GoInK13/LaserGame/Kicad/Laser-50503D.jpg

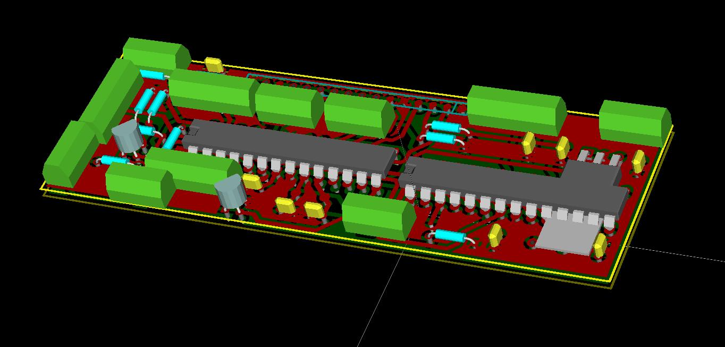
Kicad/Laser-50503D.jpg
