GoInK13/LaserGame/Programmes/SoftPCOK.png

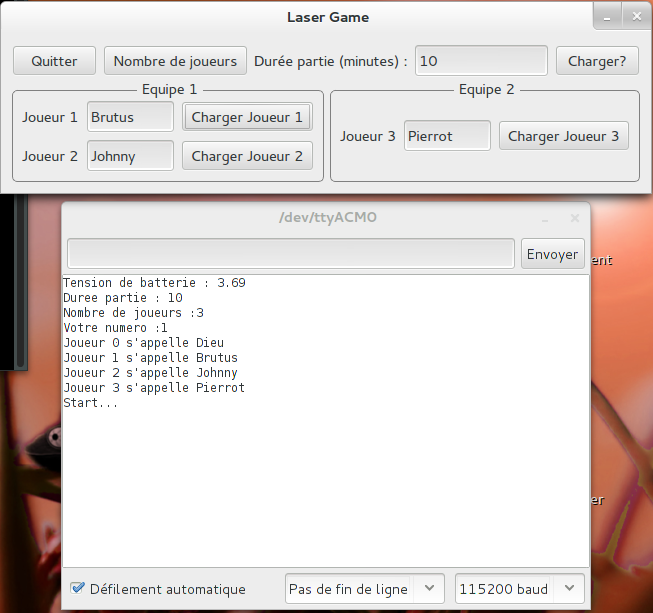
Programmes/SoftPCOK.png
