GoInK13/LaserGame/README.md

# LaserGame

The KiCAD folder contains the PCB files.
The programm folder contains the 2 programs for Arduino and the software to export names on the gun.

If you wanna see a video about it :  
https://www.youtube.com/watch?v=VjxKDo3n8c4
