GoInK13/LaserGame/Documentations/PosterProjetLaserGame_V2015_SD.pdf

# Principe du projet long

## Décomposé en 4 séquences :

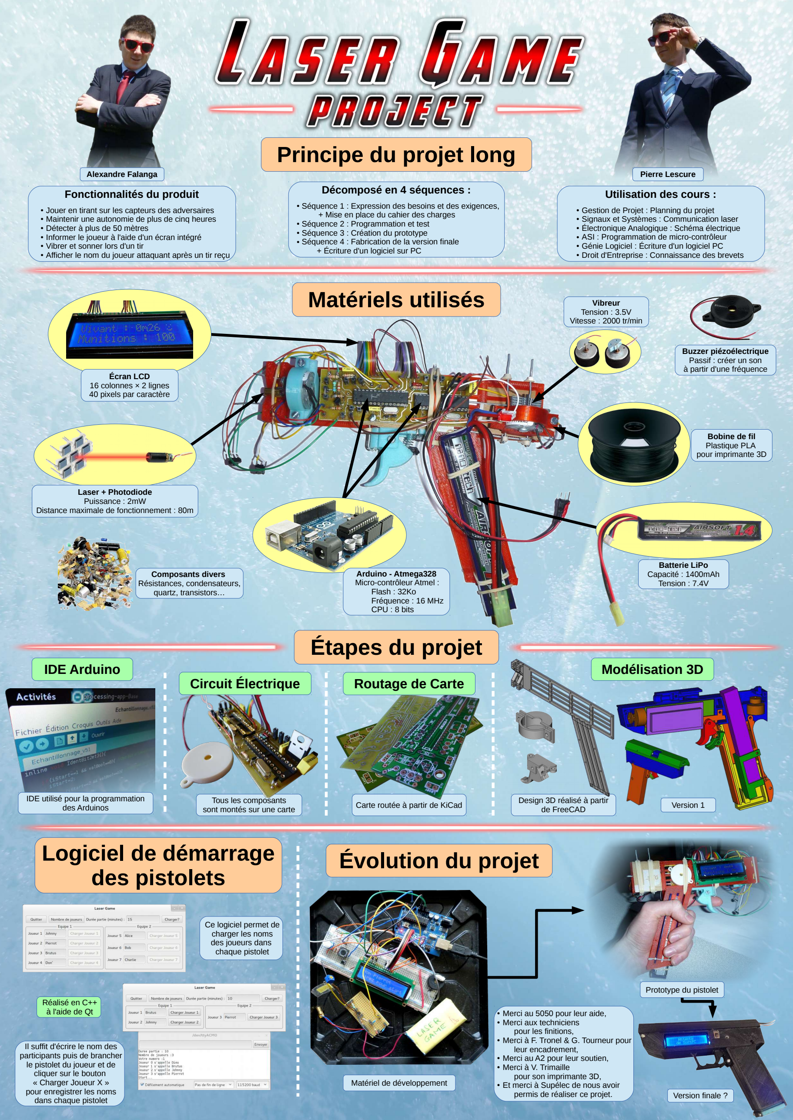
[picture p3: page 1]

# Matériels utilisés

- Séquence 1 : Expression des besoins et des exigences, + Mise en place du cahier des charges
- Séquence 2 : Programmation et test
- Séquence 3 : Création du prototype
- Séquence 4 : Fabrication de la version finale + Écriture d'un logiciel sur PC

Alexandre Falanga

## Fonctionnalités du produit

- Jouer en tirant sur les capteurs des adversaires
- Maintenir une autonomie de plus de cinq heures
- Détecter à plus de 50 mètres
- Informer le joueur à l'aide d'un écran intégré
- Vibrer et sonner lors d'un tir
- Afficher le nom du joueur attaquant après un tir reçu

Pierre Lescure

## Utilisation des cours :

- Gestion de Projet : Planning du projet
- Signaux et Systèmes : Communication laser
- Électronique Analogique : Schéma électrique
- ASI : Programmation de micro-contrôleur
- Génie Logiciel : Écriture d'un logiciel PC
- Droit d'Entreprise : Connaissance des brevets

Vibreur
Tension : 3.5V
Vitesse : 2000 tr/min

Buzzer piézoélectrique
Passif : créer un son
à partir d'une fréquence

Bobine de fil
Plastique PLA
pour imprimante 3D

Batterie LiPo
Capacité : 1400mAh
Tension : 7.4V

Arduino - Atmega328
Micro-contrôleur Atmel :
Flash : 32Ko
Fréquence : 16 MHz
CPU : 8 bits

Composants divers
Résistances, condensateurs, quartz, transistors…

Laser + Photodiode
Puissance : 2mW
Distance maximale de fonctionnement : 80m

Écran LCD
16 colonnes × 2 lignes
40 pixels par caractère

## IDE Arduino Circuit Électrique

## Modélisation 3D

# Étapes du projet

# Évolution du projet Logiciel de démarrage des pistolets

Ce logiciel permet de
charger les noms
des joueurs dans
chaque pistolet

Réalisé en C++
à l'aide de Qt

Il suffit d'écrire le nom des participants puis de brancher le pistolet du joueur et de cliquer sur le bouton
« Charger Joueur X »
pour enregistrer les noms
dans chaque pistolet

Matériel de développement

- Merci au 5050 pour leur aide,
- Merci aux techniciens
pour les finitions,
- Merci à F. Tronel & G. Tourneur pour leur encadrement,
- Merci au A2 pour leur soutien,
- Merci à V. Trimaille
pour son imprimante 3D,
- Et merci à Supélec de nous avoir permis de réaliser ce projet.

Prototype du pistolet

Version finale ?

IDE utilisé pour la programmation des Arduinos

Tous les composants
sont montés sur une carte

Carte routée à partir de KiCad

## Routage de Carte

Design 3D réalisé à partir de FreeCAD

Version 1
