GoInK13/LaserGame/Kicad/Laser01-5050-PlanDeMasse.pdf

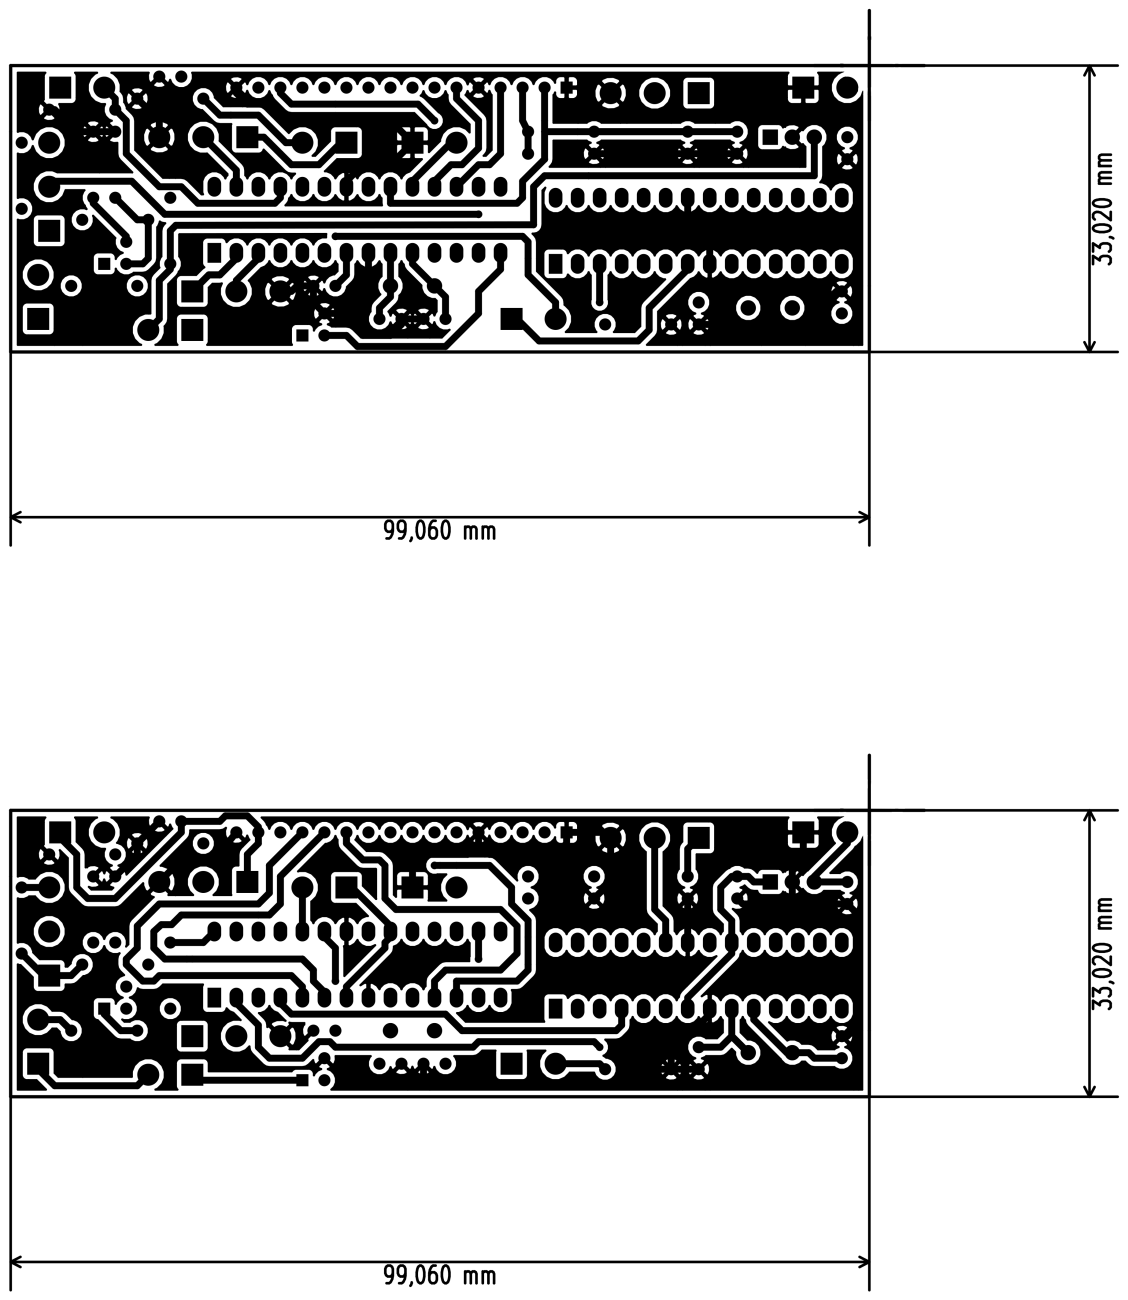
[picture p5: page 1]
