GoInK13/LaserGame/Kicad/Laser01-5050-V2SSMasse.pdf

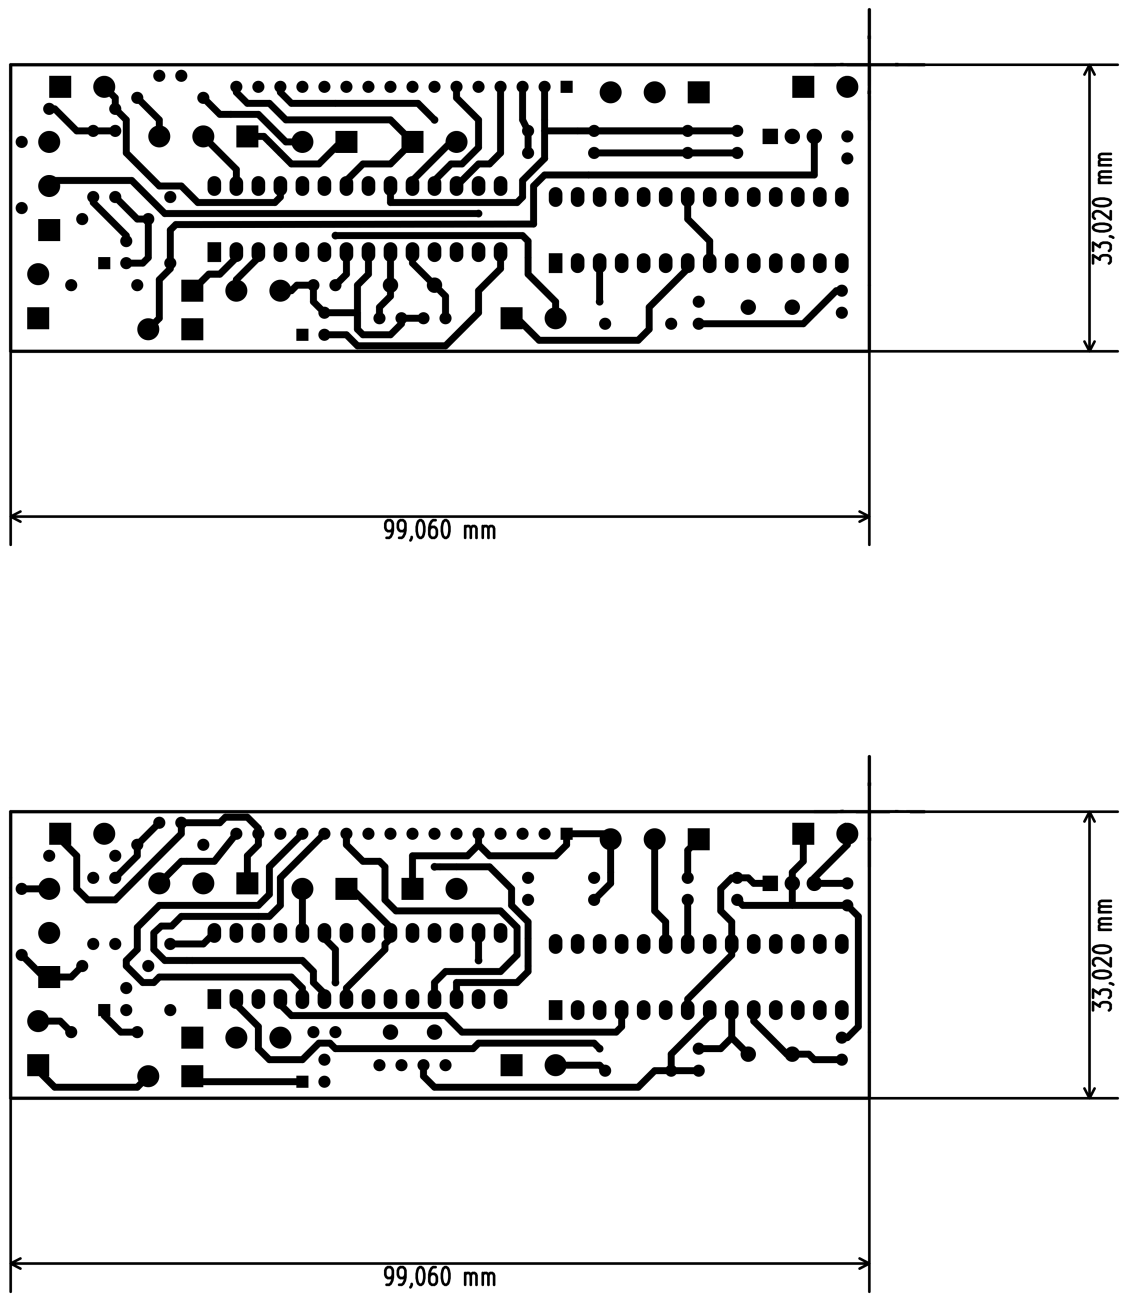
[picture p6: page 1]
