GoInK13/LaserGame/Kicad/Laser01-5050-V3-PDM.pdf

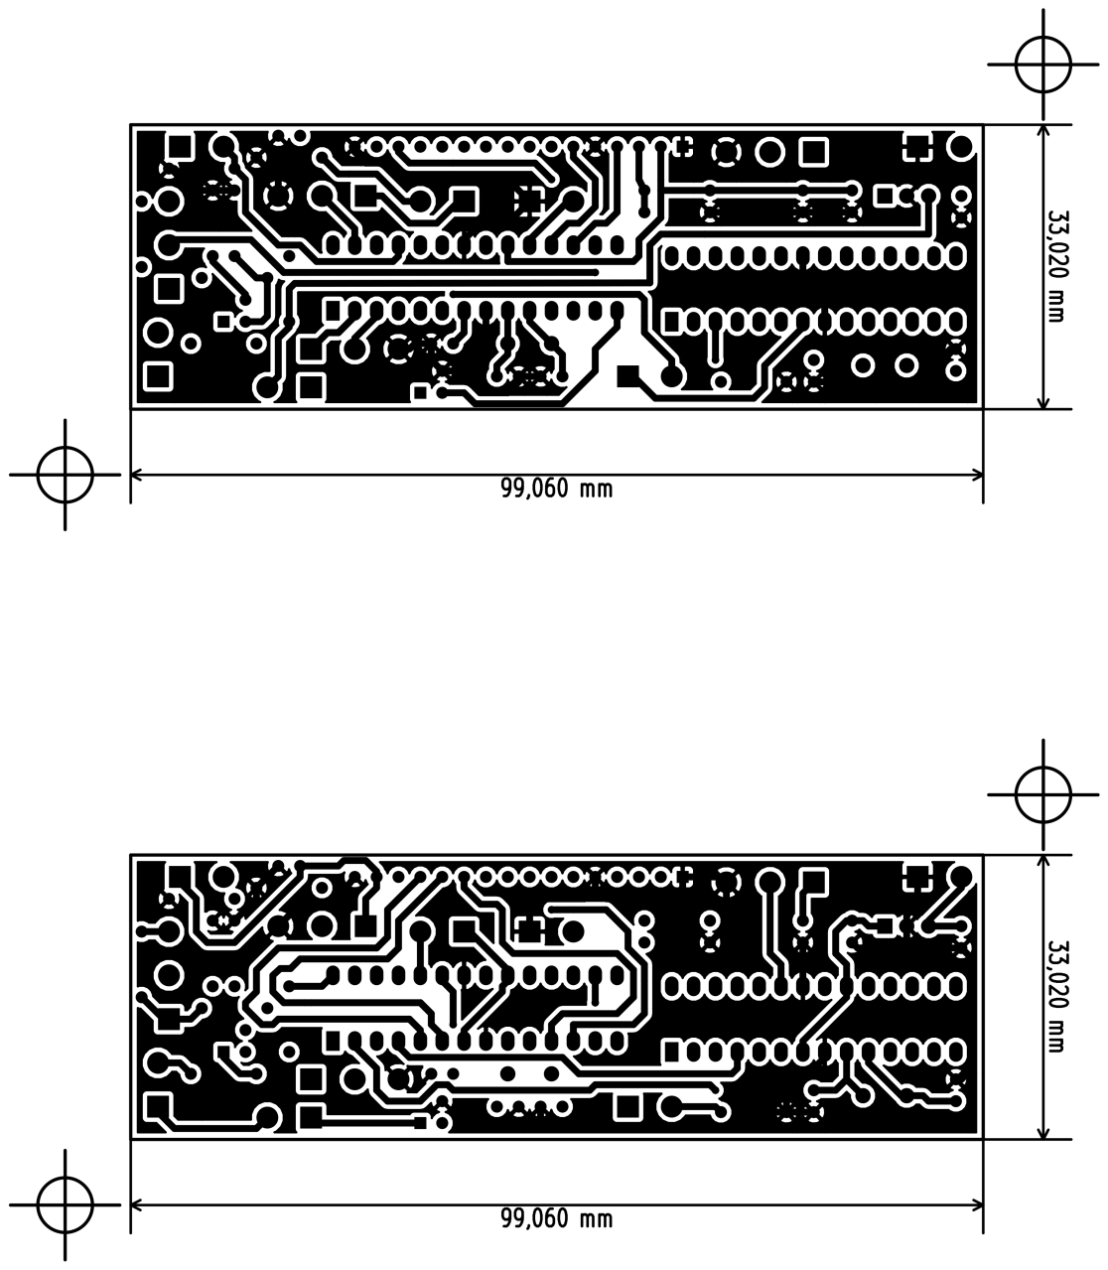
[picture p7: page 1]
