GoInK13/LaserGame/Kicad/Laser01-5050.pdf

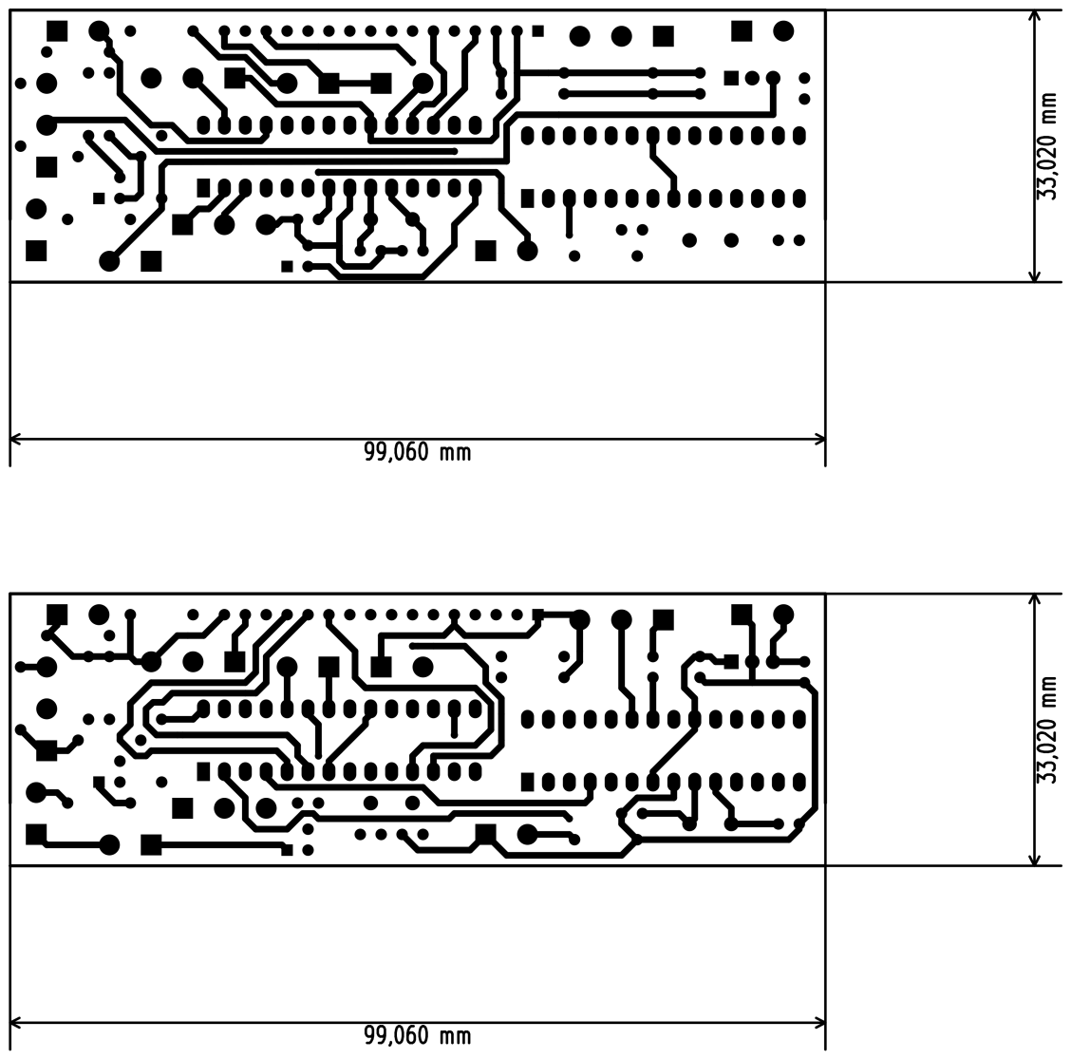
[picture p8: page 1]
