GoInK13/LaserGame/Kicad/Laser01-Routage.pdf

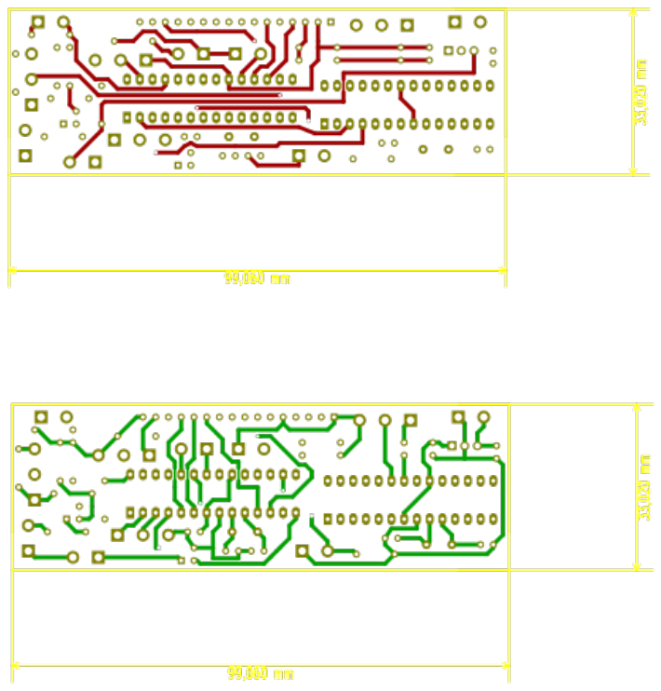
[picture p9: page 1]
