GoInK13/LaserGame/Kicad/Laser01-Routage2.pdf

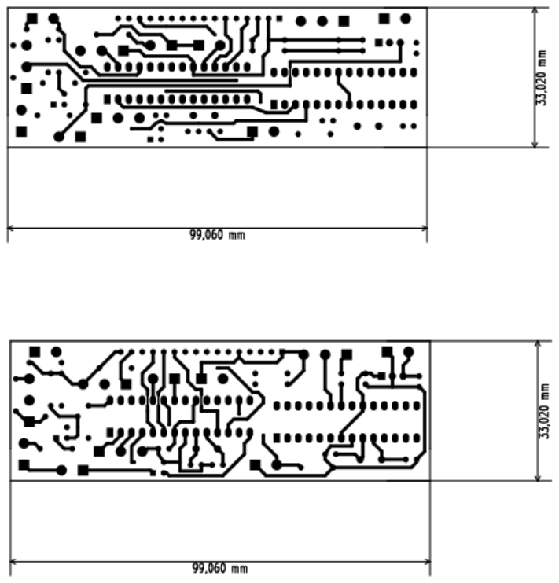
[picture p10: page 1]
