GoInK13/LaserGame/Kicad/Routage5050-0418.pdf

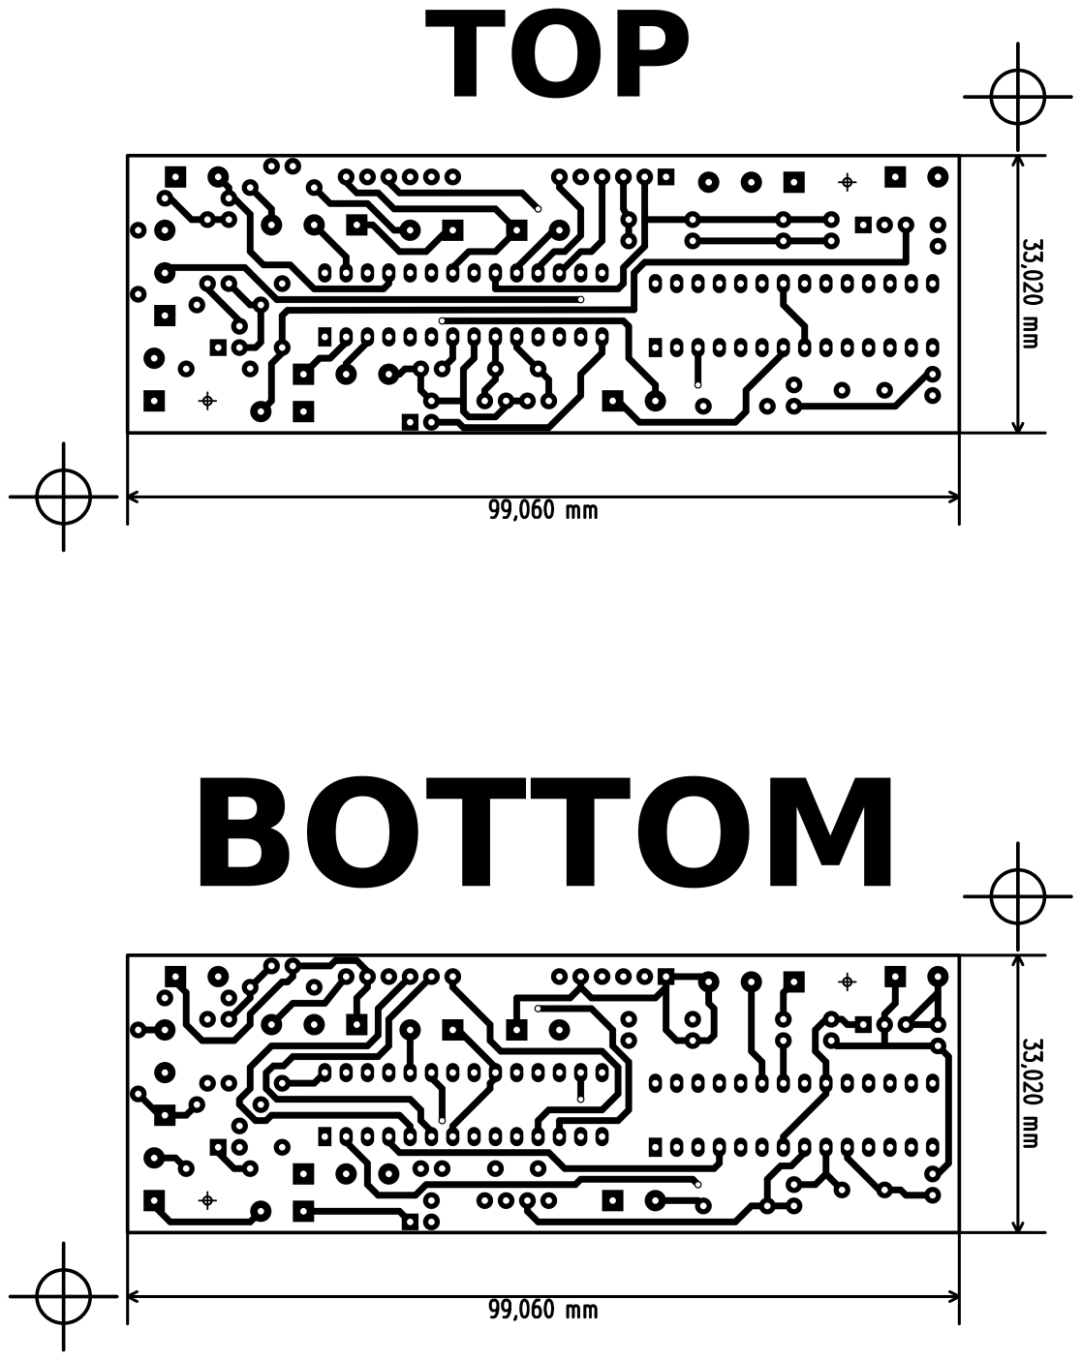
[picture p11: page 1]
