GoInK13/LaserGame/Kicad/Laser01-5050.jpg

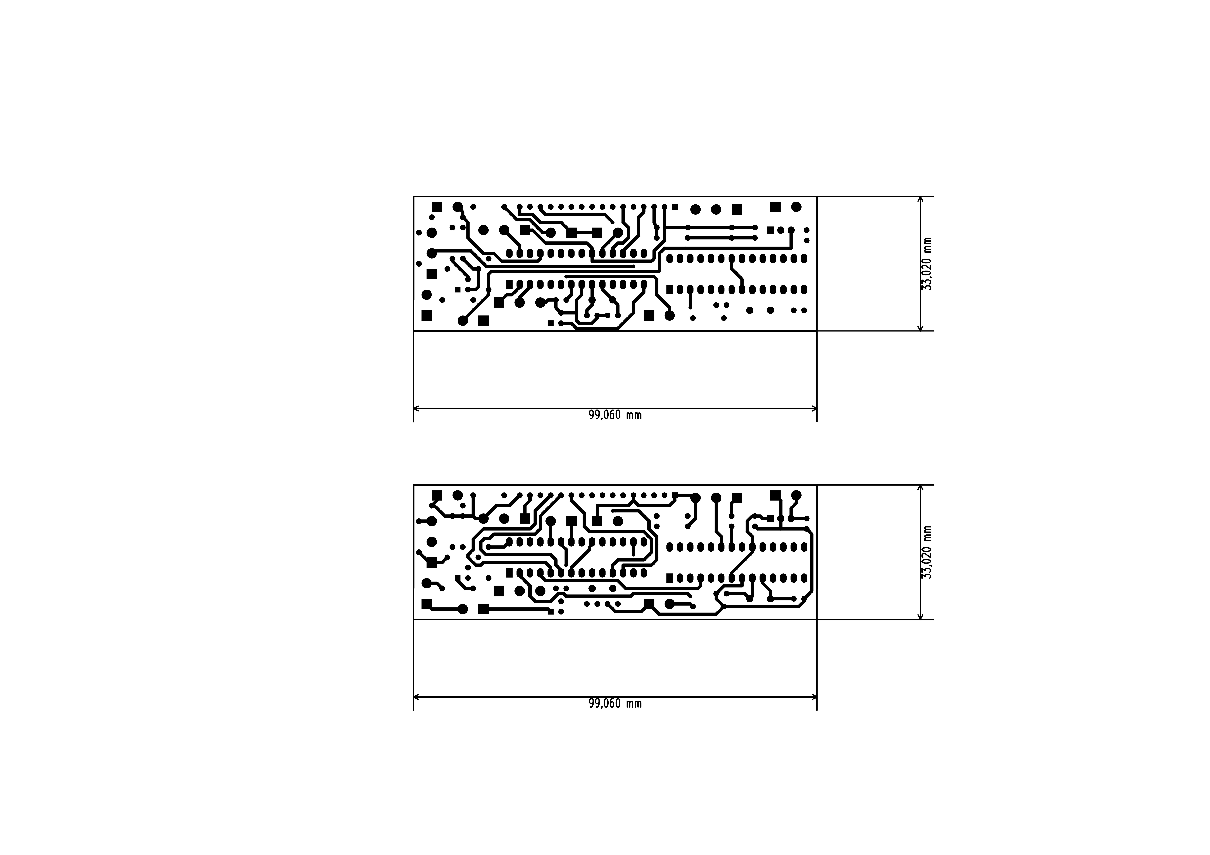
Kicad/Laser01-5050.jpg
