GoInK13/LaserGame/FreeCAD/crosseDroite.fcstd

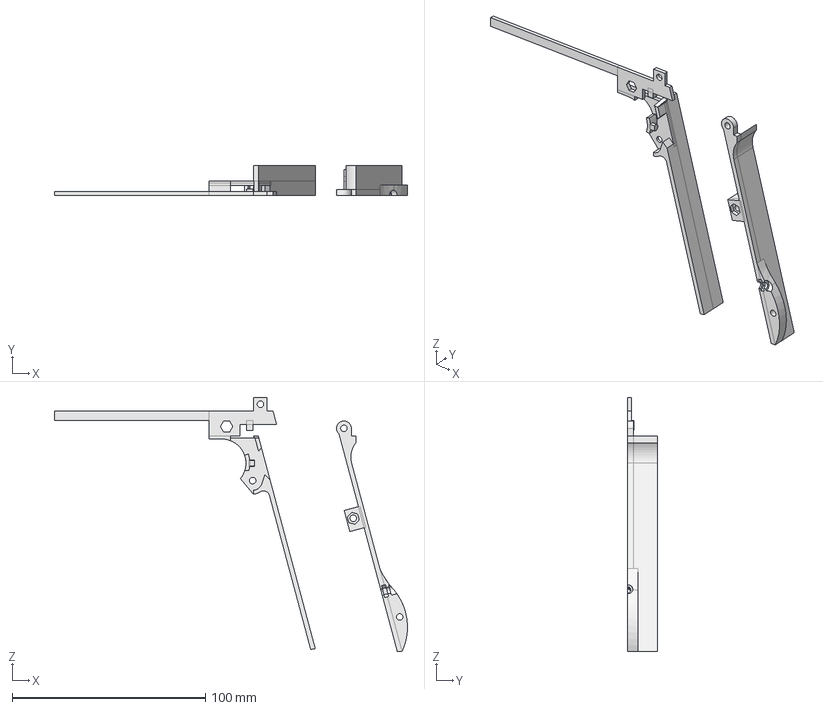
[picture p13: CAD file, 2017-12-06]
FreeCAD/crosseDroite.fcstd
182.5 x 15.5 x 131.4 mm
