GoInK13/LaserGame/FreeCAD/NgachetteTir.fcstd

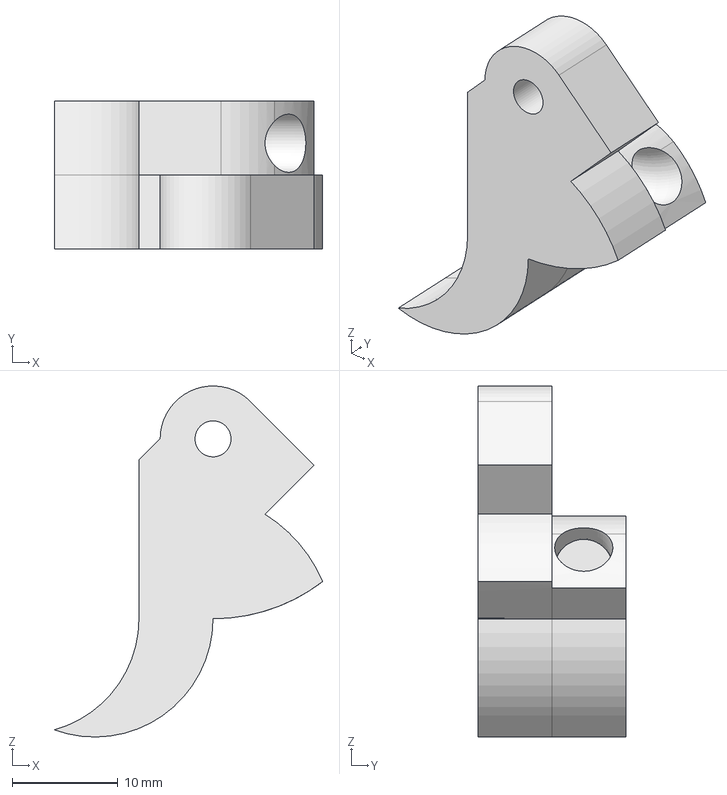
[picture p14: CAD file, 2017-12-06]
FreeCAD/NgachetteTir.fcstd
25.4 x 14.0 x 33.2 mm
