GoInK13/LaserGame/FreeCAD/HautGaucheEscroquerie.fcstd

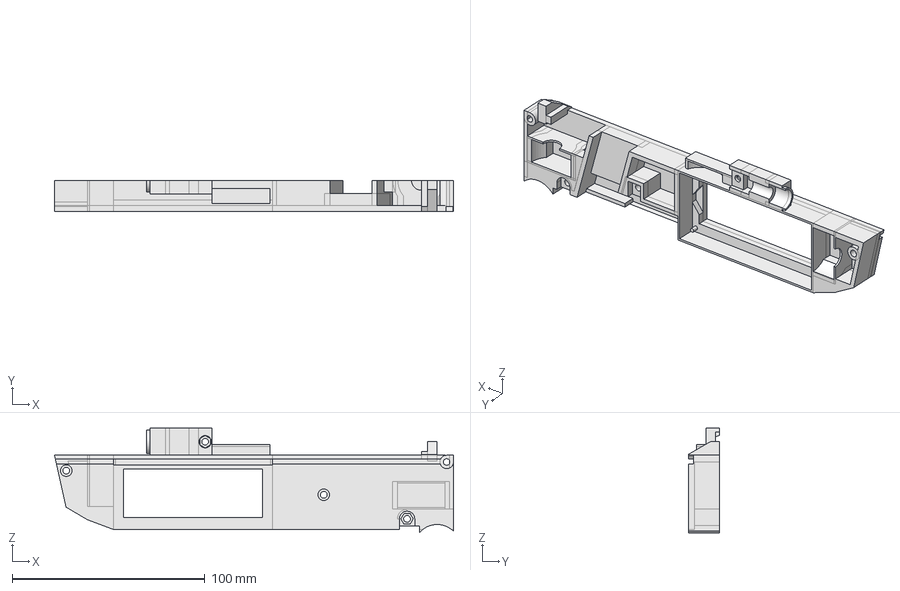
[picture p15: CAD file, 2017-12-06]
FreeCAD/HautGaucheEscroquerie.fcstd
206.8 x 16.0 x 54.2 mm
