GoInK13/LaserGame/FreeCAD/NHautDroit.fcstd

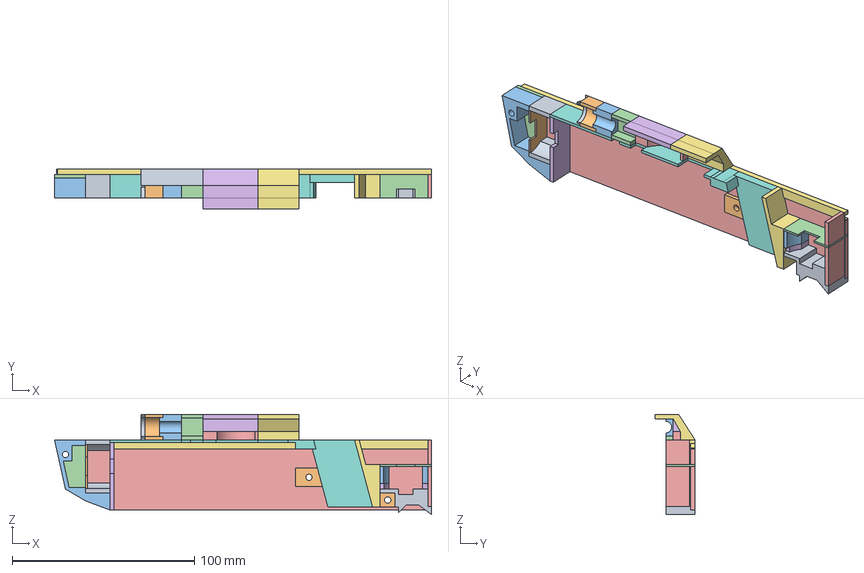
[picture p16: CAD file, 2017-12-06]
FreeCAD/NHautDroit.fcstd
206.7 x 22.0 x 55.0 mm
g base
g base3
g3 attache moteur1
g3 attache moteur2
g3 derriere
g3 attache moteur3
g3 derriere cp2
g4 c4 extreme
g6 devant c1
g6 devant c2
g6 devant décor c1
g6 devant decor c2
extreme droit
g6 devant c3
rainure droit
g7 Cext rebord batterie
g2 glissiere1-
g2 glissiere2-
g2 glissiere3-
g2 glissiere c4
g10 buzzer c1
g10 c3
g10 c4
cadre haut
g10 c5
trou vis centre
