GoInK13/LaserGame/FreeCAD/HautDroit.fcstd

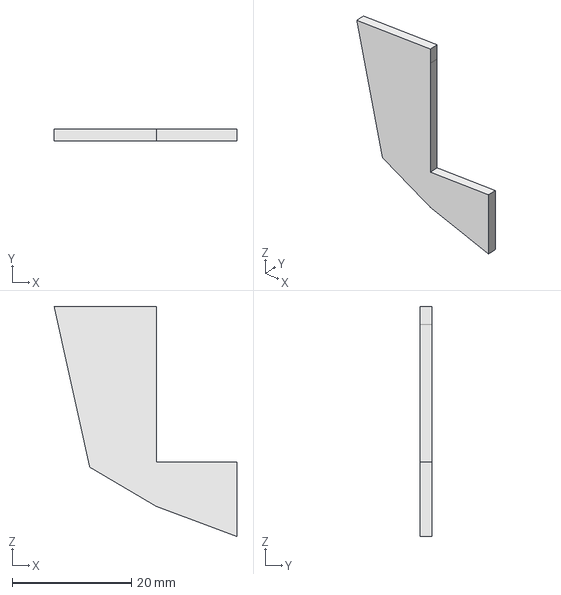
[picture p17: CAD file, 2017-12-06]
FreeCAD/HautDroit.fcstd
30.6 x 2.00 x 38.5 mm
