GoInK13/LaserGame/FreeCAD/intérieur.fcstd

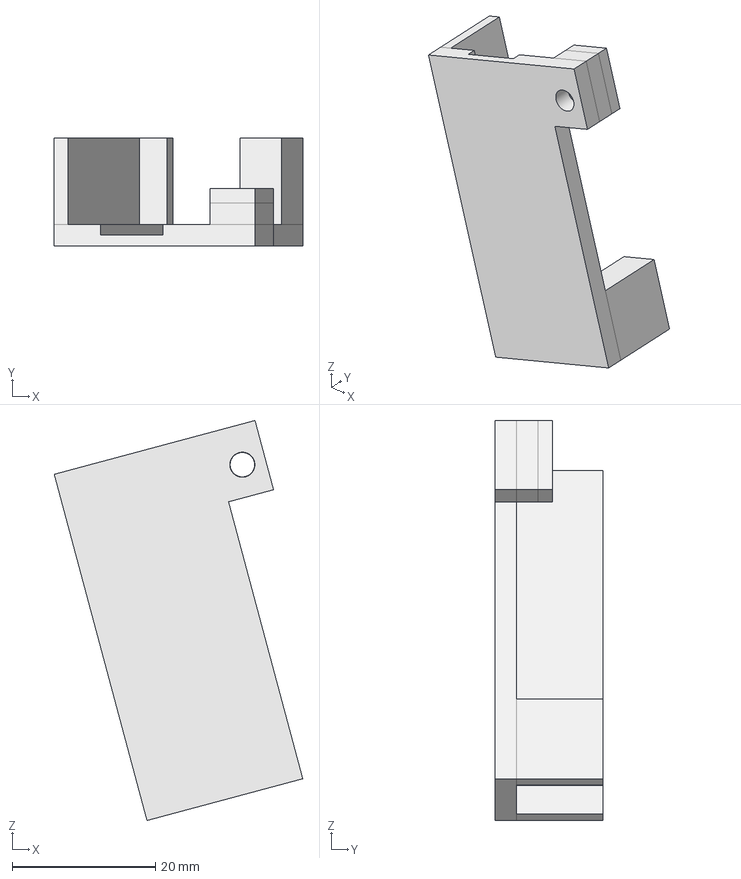
[picture p18: CAD file, 2017-12-06]
FreeCAD/intérieur.fcstd
34.7 x 15.0 x 55.8 mm
