GoInK13/LaserGame/FreeCAD/NCrosseGauche.fcstd

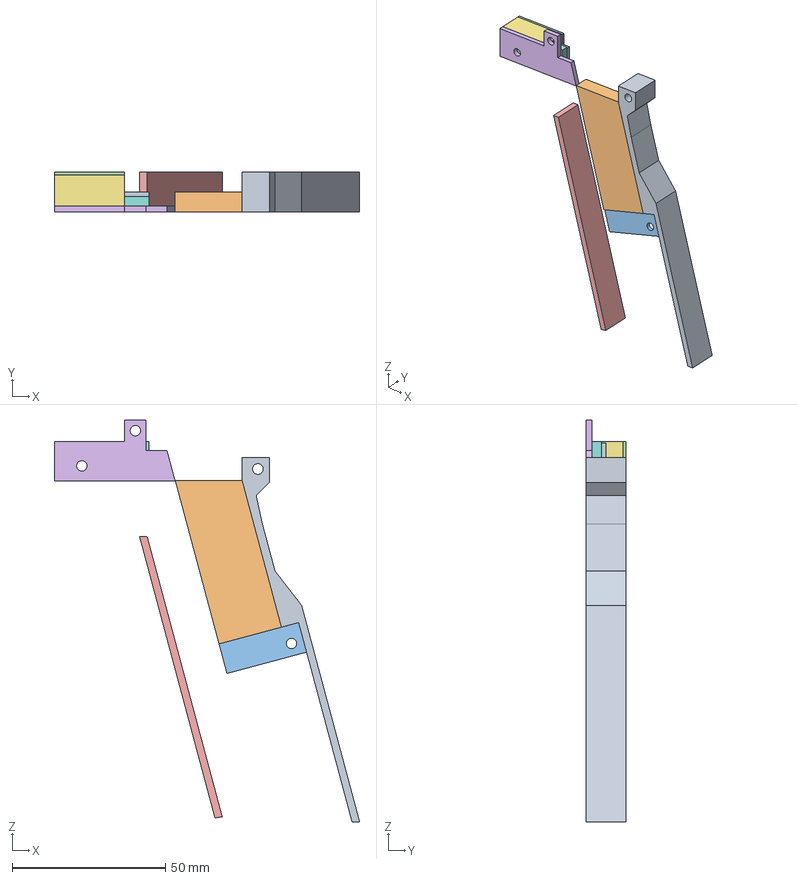
[picture p19: CAD file, 2017-12-06]
FreeCAD/NCrosseGauche.fcstd
99.8 x 13.0 x 131.3 mm
g1 c3
g1 c2
g1 c1 bat
g31 c1
devant c4 coupée
g31 c5
g31 c2
g31 c4
attache gach tir g41
