GoInK13/LaserGame/FreeCAD/crosseGauche.fcstd

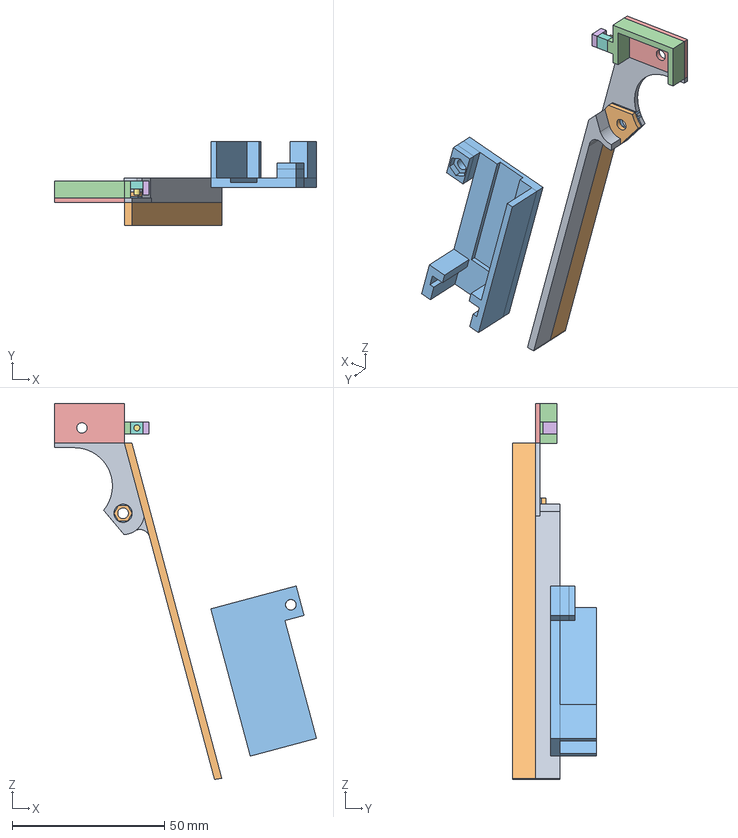
[picture p20: CAD file, 2017-12-06]
FreeCAD/crosseGauche.fcstd
85.9 x 27.5 x 123.3 mm
devant1 g2
bord couche1+ g2
bord couche2 g2
interieur gachette g3
gachette dessus g3
gachette suite2
Cylinder gachette suite3
gachette suite1
devant couche3 g2
devant couche4 g2
inte
