GoInK13/LaserGame/(list of files, cad)

Other CAD files:
FreeCAD/NHautGauche.fcstd
