GoInK13/LaserGame/Kicad/Laser02.sch

## KiCad design Kicad/Laser02.sch (2016-09-28)

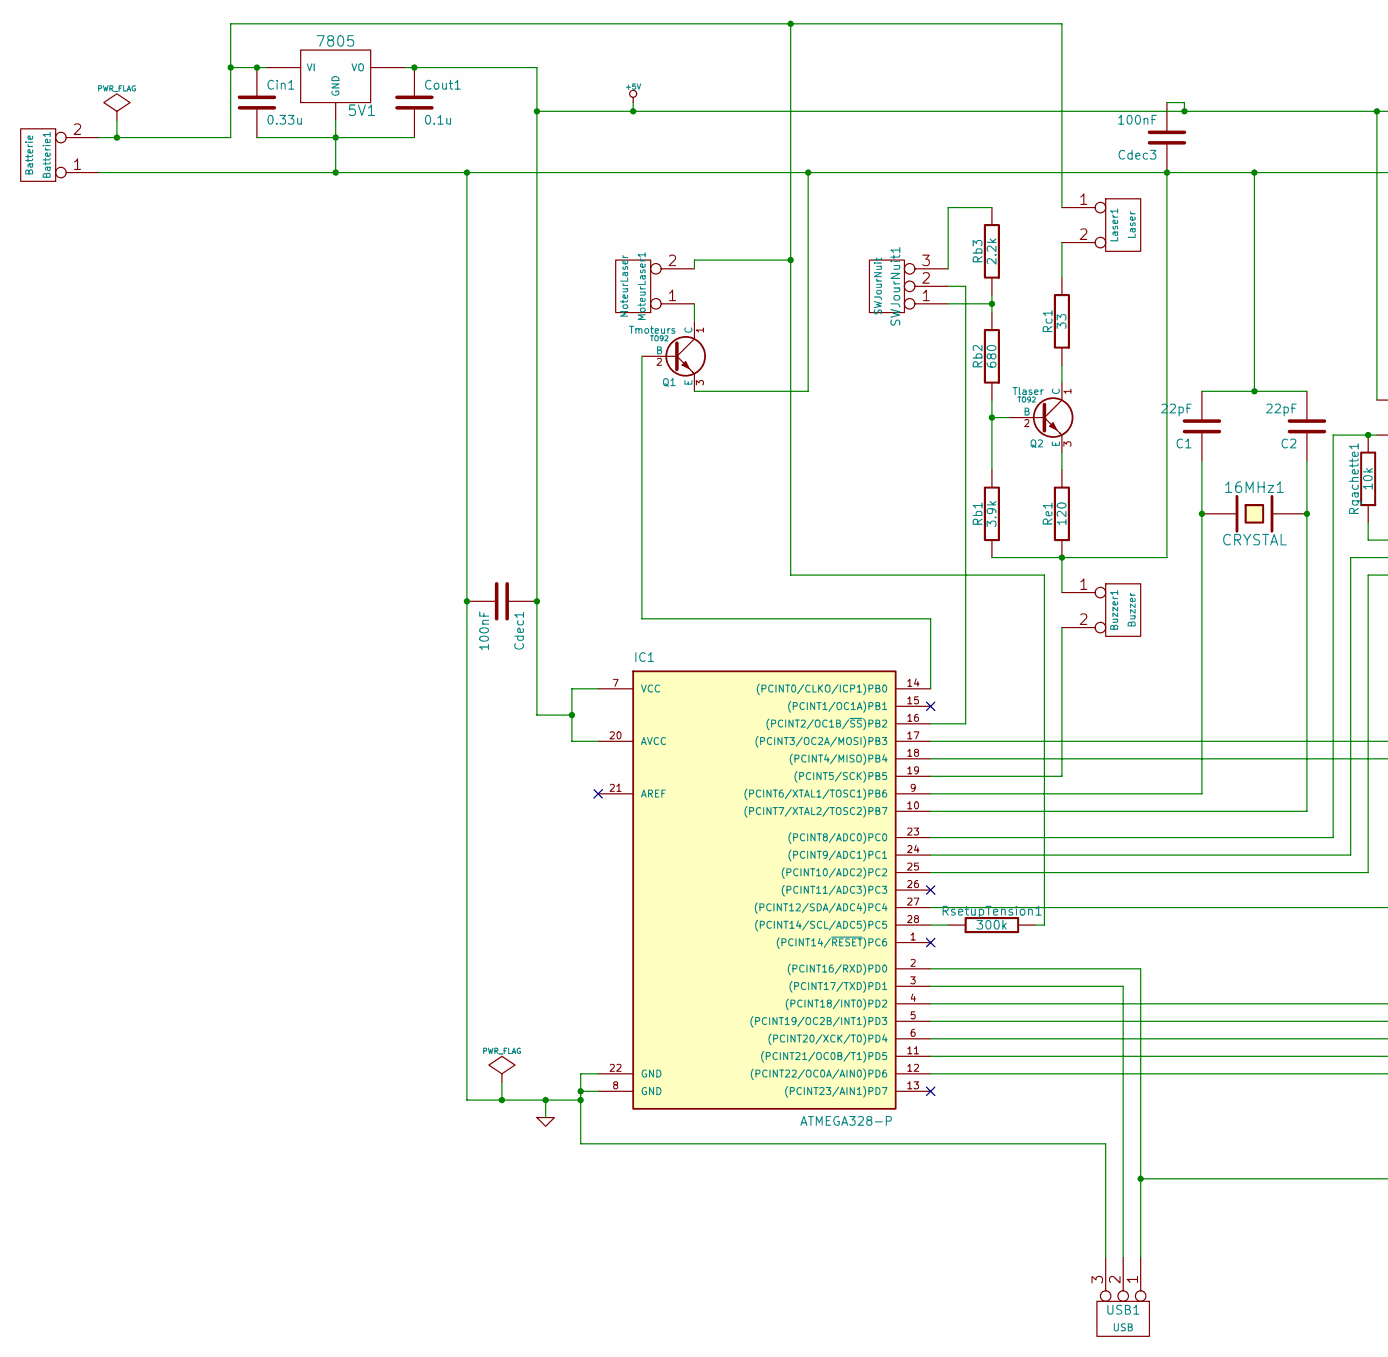
[picture p21: schematic Laser02.sch, part in row 1, column 1]

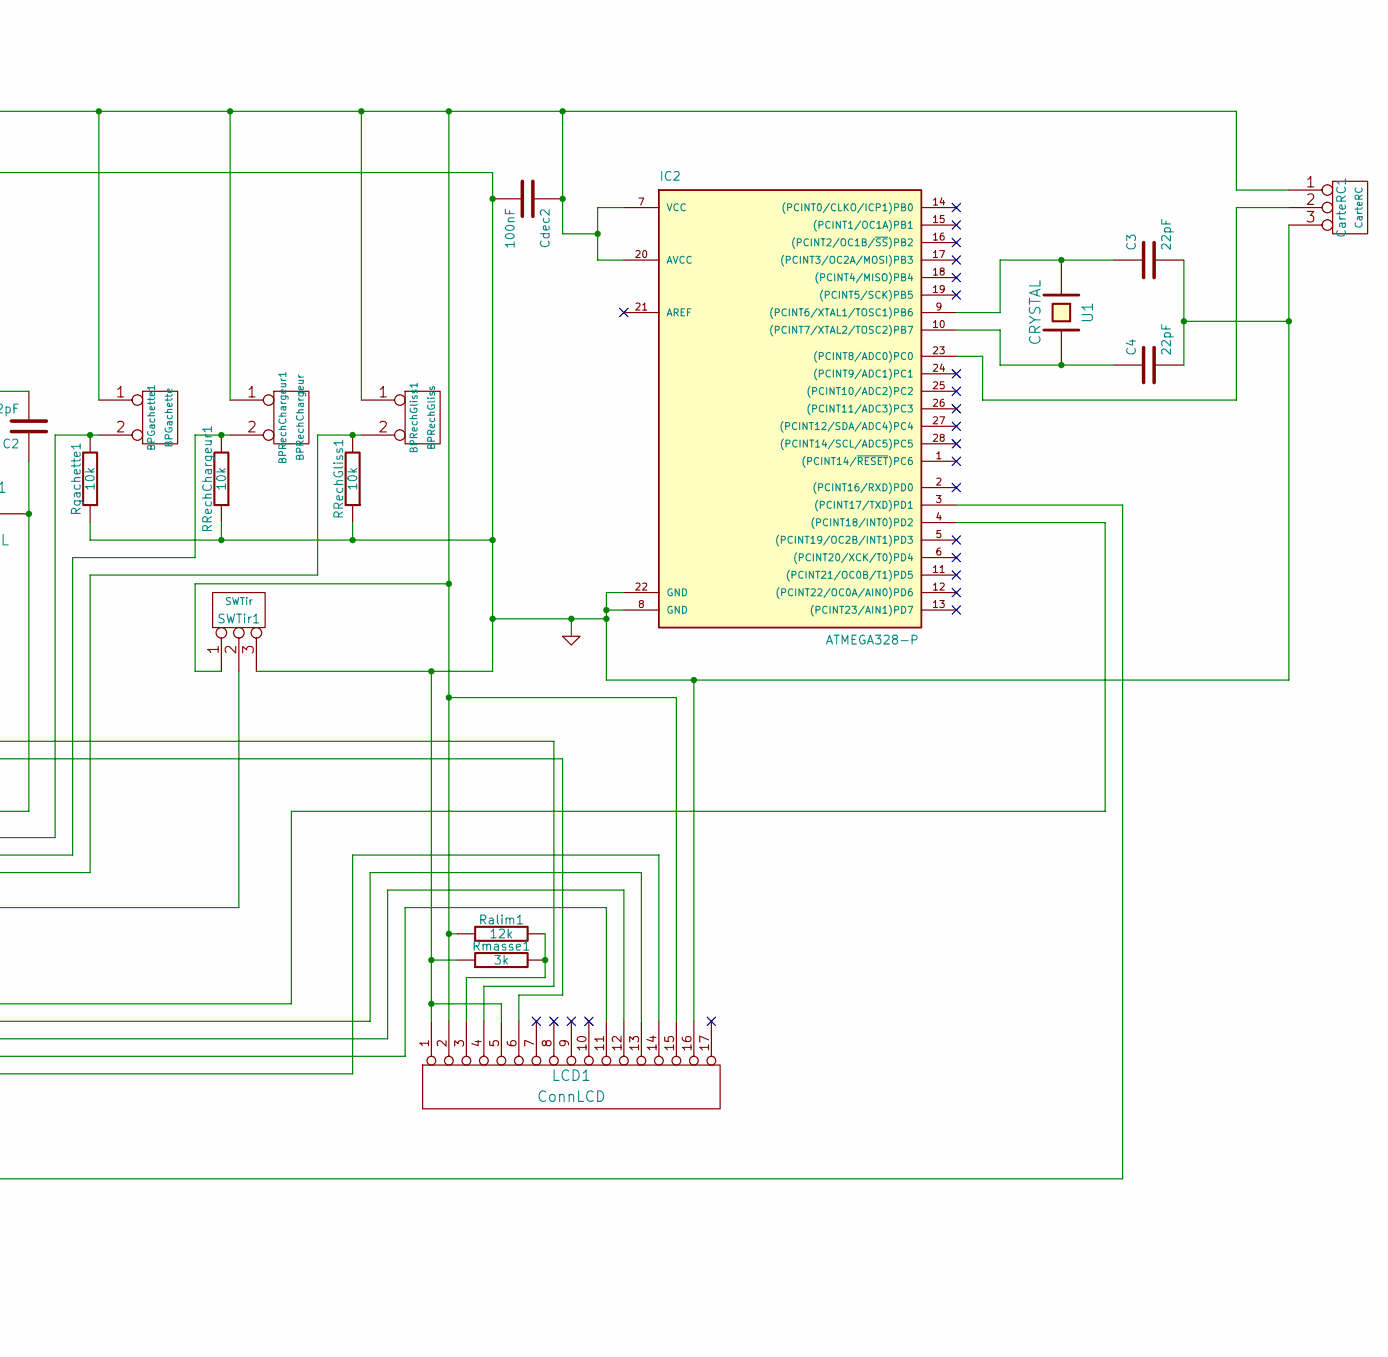
[picture p22: schematic Laser02.sch, part in row 1, column 2]

Parts:
5V1: 7805
16MHz1: CRYSTAL
BPGachette1: BPGachette
BPRechChargeur1: BPRechChargeur
BPRechGliss1: BPRechGliss
Batterie1: Batterie
Buzzer1: Buzzer
C1, C2, C3, C4: 22pF
CarteRC1: CarteRC
Cdec1, Cdec2, Cdec3: 100nF
Cin1: 0.33u
Cout1: 0.1u
IC1, IC2: ATMEGA328-P; DIL28
LCD1: ConnLCD
Laser1: Laser
MoteurLaser1: MoteurLaser
Q1: Tmoteurs; TO92
Q2: Tlaser; TO92
RRechChargeur1: 10k
RRechGliss1: 10k
Ralim1: 12k
Rb1: 3.9k
Rb2: 680
Rb3: 2.2k
Rc1: 33
Re1: 120
Rgachette1: 10k
Rmasse1: 3k
RsetupTension1: 300k
SWJourNuit1: SWJourNuit
SWTir1: SWTir
U1: CRYSTAL
USB1: USB

Connections:
+5V: 5V1.VO, BPGachette1.1, BPRechChargeur1.1, BPRechGliss1.1, CarteRC1.1, Cdec1.1, Cdec2.1, Cdec3.2, Cout1.1, IC1.7 (VCC), IC1.20 (AVCC), IC2.7 (VCC), IC2.20 (AVCC), LCD1.2, LCD1.15, Ralim1.1, SWTir1.1
GND: 5V1.GND, Batterie1.1, Buzzer1.1, C1.2, C2.2, C3.2, C4.2, CarteRC1.3, Cdec1.2, Cdec2.2, Cdec3.1, Cin1.2, Cout1.2, IC1.8 (GND), IC1.22 (GND), IC2.8 (GND), IC2.22 (GND), LCD1.1, LCD1.5, LCD1.16, Q1.3 (E), RRechChargeur1.1, RRechGliss1.1, Rb1.1, Re1.1, Rgachette1.1, Rmasse1.1, SWTir1.3, USB1.3
unnamed: 5V1.VI, Batterie1.2 (PM), Cin1.1, Laser1.1, MoteurLaser1.2 (PM), RsetupTension1.2
unnamed: 16MHz1.1, C1.1, IC1.9 ((PCINT6/XTAL1/TOSC1)PB6)
unnamed: 16MHz1.2, C2.1, IC1.10 ((PCINT7/XTAL2/TOSC2)PB7)
unnamed: BPGachette1.2 (PM), IC1.23 ((PCINT8/ADC0)PC0), Rgachette1.2
unnamed: BPRechChargeur1.2 (PM), IC1.24 ((PCINT9/ADC1)PC1), RRechChargeur1.2
unnamed: BPRechGliss1.2 (PM), IC1.25 ((PCINT10/ADC2)PC2), RRechGliss1.2
unnamed: Buzzer1.2 (PM), IC1.19 ((PCINT5/SCK)PB5)
unnamed: C3.1, IC2.9 ((PCINT6/XTAL1/TOSC1)PB6), U1.1
unnamed: C4.1, IC2.10 ((PCINT7/XTAL2/TOSC2)PB7), U1.2
unnamed: CarteRC1.2 (PM), IC2.23 ((PCINT8/ADC0)PC0)
unnamed: IC1.2 ((PCINT16/RXD)PD0), IC2.3 ((PCINT17/TXD)PD1), USB1.1
unnamed: IC1.3 ((PCINT17/TXD)PD1), USB1.2 (PM)
unnamed: IC1.4 ((PCINT18/INT0)PD2), IC2.4 ((PCINT18/INT0)PD2)
unnamed: IC1.5 ((PCINT19/OC2B/INT1)PD3), LCD1.13
unnamed: IC1.6 ((PCINT20/XCK/T0)PD4), LCD1.12
unnamed: IC1.11 ((PCINT21/OC0B/T1)PD5), LCD1.11
unnamed: IC1.12 ((PCINT22/OC0A/AIN0)PD6), LCD1.14
unnamed: IC1.14 ((PCINT0/CLKO/ICP1)PB0), Q1.2 (B)
unnamed: IC1.16 ((PCINT2/OC1B/~SS~)PB2), SWJourNuit1.2 (PM)
unnamed: IC1.17 ((PCINT3/OC2A/MOSI)PB3), LCD1.4
unnamed: IC1.18 ((PCINT4/MISO)PB4), LCD1.6
unnamed: IC1.27 ((PCINT12/SDA/ADC4)PC4), SWTir1.2 (PM)
unnamed: IC1.28 ((PCINT14/SCL/ADC5)PC5), RsetupTension1.1
unnamed: LCD1.3, Ralim1.2, Rmasse1.2
unnamed: Laser1.2 (PM), Rc1.2
unnamed: MoteurLaser1.1, Q1.1 (C)
unnamed: Q2.1 (C), Rc1.1
unnamed: Q2.2 (B), Rb1.2, Rb2.1
unnamed: Q2.3 (E), Re1.2
unnamed: Rb2.2, Rb3.1, SWJourNuit1.1
unnamed: Rb3.2, SWJourNuit1.3
