GoInK13/LaserGame/(commit log)

2016-09-28 Push all files
    [Laser01-5050.brd, Laser01-5050V4GrossePastille.brd, Laser01.brd, Laser01.sch, Laser02.sch, Sécu-calculs sécurité.ods, Sécu-diamètre_laser_en fonctionde_la_distance.ods]
2017-12-06 Ajout du schema de cablage.
2017-12-06 Add FreeCAD
    [HautDroit.fcstd, HautGaucheEscroquerie.fcstd, NCrosseGauche.fcstd, NHautDroit.fcstd, NHautGauche.fcstd, NgachetteTir.fcstd, crosseDroite.fcstd, crosseGauche.fcstd]
